LeClubSandwichStudio/LaCOOLBoardHardware/README.md

# LaCOOLBoardHardware

Eagle files and BOM for La COOL Board

<br />This work is licensed under a <a rel="license" href="http://creativecommons.org/licenses/by-sa/4.0/">Creative Commons Attribution-ShareAlike 4.0 International License</a>.
