LeClubSandwichStudio/LaCOOLBoardHardware/lacoolBoard_V1.1.3.sch

## EAGLE design lacoolBoard_V1.1.3.sch (2018-01-08)

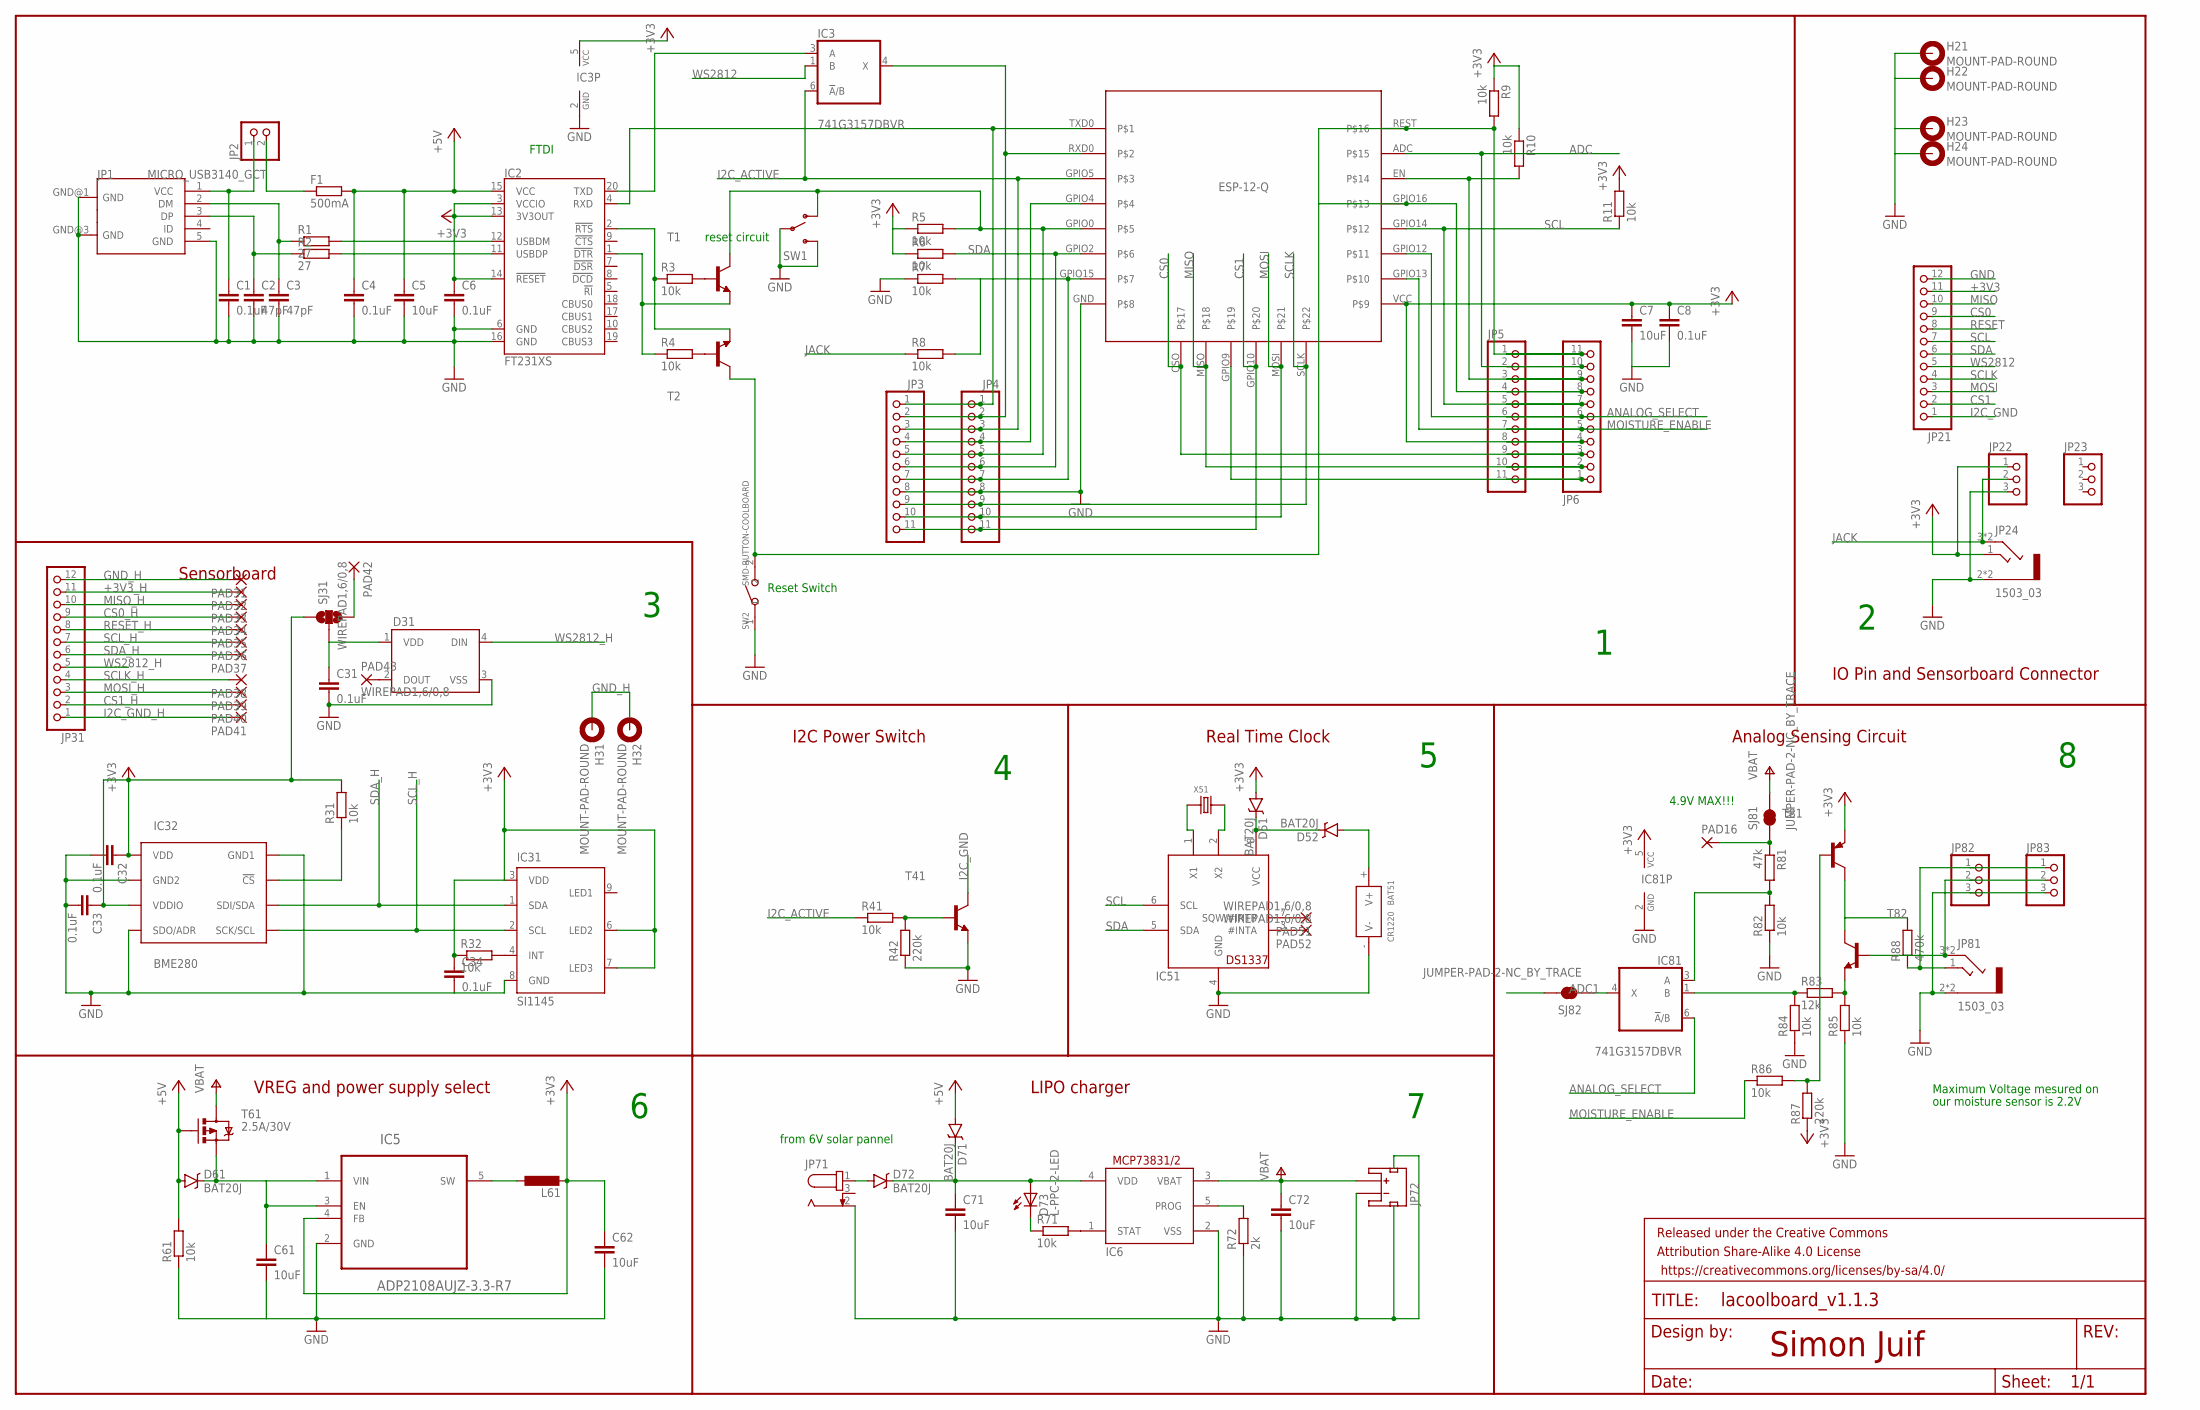
[picture p1: schematic lacoolBoard_V1.1.3.sch]

Parts:
BAT51: CR1220; BAT2P-SMD-16.4-CR1220
C1, C4, C6, C8, C31, C32, C33, C34: 0.1uF; C0603K
C2, C3: 47pF; C0603K
C5, C7, C61, C62, C71, C72: 10uF; C0603K
D31: WS2812B
D51, D52, D61, D71, D72: BAT20J; SOD-323
D73: L-PPC-2-LED; P-LCC-2
F1: 500mA; M0805
FRAME1: FRAME-LEDGER; CREATIVE_COMMONS
H21, H22, H23, H24, H31, H32: MOUNT-PAD-ROUND; 2,4-PAD
IC1: ESP12_ENGRAVE; ESP12Q-ENGRAVE
IC2: FT231XS; SSOP20_L
IC3, IC81: 741G3157DBVR; DBV_R-PDSO-G6
IC5: ADP2108AUJZ-3.3-R7; SOT95P280X100-5N
IC6: MCP73831/OT; SOT23-5L
IC31: SI1145; QFN-10
IC32: BME280; BME280_LGA
IC51: DS1337; SOIC8
JP1: MICRO_USB3140_GCT; USB3140-30-0230-1-C
JP2: PINHD-1X2SMALLHOLE; 1X02SMALLHOLE
JP3, JP6: PINHD-1X11/90; 1X11/90
JP4, JP5: PINHD-1X11; 1X11
JP21, JP31: PINHD-1X12; 1X12
JP22, JP23, JP82, JP83: PINHD-1X3; 1X03
JP24, JP81: 1503_03
JP71: 694108402002
JP72: JST_2MM_MALE; JST-2-SMD
L61: L-EUVLS3015; VLS3015
PAD16, PAD31, PAD32, PAD33, PAD34, PAD35, PAD36, PAD37, PAD38, PAD39, PAD40, PAD41: SMD2; SMD1,27-2,54
PAD42, PAD43, PAD51, PAD52: WIREPAD1,6/0,8; 1,6/0,8
R1, R2: 27; R0603
R3, R4, R5, R6, R7, R8, R9, R10, R11, R31, R32, R41, R61, R71, R82, R84, R85, R86: 10k; R0603
R42, R87: 220k; R0603
R72: 2k; R0603
R81: 47k; R0603
R83: 12k; R0603
R88: 470k; R0603
SJ31: SOLDERJUMPER_2WAYPASTE1&2; SJ_3_PASTE1&2
SJ81, SJ82: JUMPER-PAD-2-NC_BY_TRACE; PAD-JUMPER-2-NC_BY_TRACE_YES_SILK
SW1: SWITCH-SPDT-SMD-A; SWITCH-SPST-SMD-A
SW2: SMD-BUTTON-COOLBOARD; 1437566-3_COOLBOARD
T1, T2: MMBT2222ALT1-NPN-SOT23-BEC; SOT23-BEC
T41, T82: MMBT3904LT1-NPN-SOT23-BEC; SOT23-BEC
T61: 2.5A/30V; SOT23-3
T81: MMBT3906LT1-PNP-SOT23-BEC; SOT23-BEC
X51: CRYSTAL'NX2012SA'; X2-SMD-L2.0X1.2X0.55MM

Connections:
+3V3: C6.1, C7.1, C8.1, C62.1, D51.A, IC1.VCC, IC2.3 (VCCIO), IC2.13 (3V3OUT), IC2.14 (!RESET), IC3.5 (VCC), IC5.4 (FB), IC81.5 (VCC), JP5.8, JP6.4, JP21.11, JP22.1, JP24.1 (3), L61.P$2 (2), R5.1, R6.1, R9.1, R10.1, R11.2, R87.1, T81.E
+3V3_H: C32.1, C33.1, C34.1, IC31.3 (VDD), IC31.6 (LED2), IC31.7 (LED3), IC32.P$6 (VDDIO), IC32.P$8 (VDD), JP31.11, PAD32.1, R31.2, R32.1, SJ31.1
+5V: C4.1, C5.1, D61.A, D71.A, F1.2, IC2.15 (VCC), R61.2, T61.1 (G)
ADC: IC1.ADC, JP5.2, JP6.10, SJ82.2
ADC1: IC81.4 (X), SJ82.1
ANALOG_SELECT: IC1.GPIO12, IC81.6 (!A!/B), JP5.6, JP6.6
CS0: IC1.CSO, JP5.9, JP6.3, JP21.9
CS0_H: JP31.9, PAD34.1
CS1: IC1.GPIO10, JP3.11, JP4.11, JP21.2
CS1_H: JP31.2, PAD40.1
D31: C31.2, D31.3 (VSS)
GND: BAT51.- (V-), C1.2, C2.2, C3.2, C4.2, C5.2, C6.2, C7.2, C8.2, C61.2, C62.2, C71.2, C72.2, H21.B2,4, H22.B2,4, H23.B2,4, H24.B2,4, IC1.GND, IC2.6 (GND), IC2.16 (GND), IC3.2 (GND), IC5.2 (GND), IC6.2 (VSS), IC51.4 (GND), IC81.2 (GND), JP1.5 (GND), JP1.GND@1 (GND), JP1.GND@3 (GND), JP3.8, JP4.8, JP21.12, JP22.3, JP24.2 (1), JP71.2, JP72.1 (-), JP72.NC1 (PAD1), JP72.NC2 (PAD2), JP81.2 (1), JP82.3, JP83.3, R7.1, R42.1, R61.1, R72.1, R82.1, R84.1, R85.1, SW1.2, SW1.3 (S), SW2.1, T41.E
GND_H: H31.B2,4, H32.B2,4, JP31.12, PAD31.1
GPIO4: IC1.GPIO4, JP3.4, JP4.4
I2C_ACTIVE: IC1.GPIO5, IC3.6 (!A!/B), JP3.3, JP4.3, R41.1
I2C_GND: JP21.1, T41.C
I2C_GND_H: C32.2, C33.2, C34.2, IC31.8 (GND), IC32.P$1 (GND1), IC32.P$5 (SDO/ADR), IC32.P$7 (GND2), JP31.1, PAD41.1
JACK: JP22.2, JP24.3 (2), R8.1
MISO: IC1.MISO, JP5.10, JP6.2, JP21.10
MISO_H: JP31.10, PAD33.1
MOISTURE_ENABLE: IC1.GPIO13, JP5.7, JP6.5, R86.1
MOSI: IC1.MOSI, JP3.10, JP4.10, JP21.3
MOSI_H: JP31.3, PAD39.1
unnamed: C71.1, D71.C, D72.C, D73.A, IC6.4 (VDD)
unnamed: IC6.5 (PROG), R72.2
unnamed: C1.1, JP1.1 (VCC), JP2.1
unnamed: R83.2, R85.2, T82.E
unnamed: IC31.4 (INT), R32.2
unnamed: F1.1, JP2.2
unnamed: IC6.1 (STAT), R71.2
unnamed: R88.2, T81.C, T82.C
unnamed: IC81.1 (B), R83.1, R84.2
unnamed: PAD16.1, R81.1, SJ81.1
unnamed: D72.A, JP71.1
unnamed: IC81.3 (A), R81.2, R82.2
unnamed: D73.C, R71.1
unnamed: R86.2, R87.2, T81.B
unnamed: C61.1, D61.C, IC5.1 (VIN), IC5.3 (EN), T61.2 (S)
unnamed: IC5.5 (SW), L61.P$1 (1)
unnamed: IC1.GPIO15, JP3.7, JP4.7, R7.2, R8.2
unnamed: D51.C, D52.C, IC51.8 (VCC)
unnamed: BAT51.+ (V+), D52.A
unnamed: C3.1, JP1.2 (DM), R1.1
unnamed: C2.1, JP1.3 (DP), R2.1
unnamed: IC2.12 (USBDM), R1.2
unnamed: IC2.11 (USBDP), R2.2
unnamed: IC1.EN, JP5.3, JP6.9, R10.2
unnamed: C31.1, D31.1 (VDD), SJ31.2
unnamed: IC32.P$2 (!CS), R31.1
unnamed: D31.2 (DOUT), PAD43.1
unnamed: IC51.3 (#INTA), PAD52.1
unnamed: IC51.7 (SQW/#INTB), PAD51.1
unnamed: PAD42.1, SJ31.3
unnamed: R41.2, R42.2, T41.B
unnamed: IC2.1 (!DTR), R4.1, T1.E
unnamed: R4.2, T2.B
unnamed: R3.2, T1.B
unnamed: IC2.2 (!RTS), R3.1, T2.E
unnamed: IC2.20 (TXD), IC3.3 (A)
unnamed: IC1.GPIO0, JP3.5, JP4.5, R5.2, SW1.1 (O), T1.C
unnamed: IC51.1 (X1), X51.1
unnamed: IC51.2 (X2), X51.2
unnamed: IC1.GPIO9, JP5.11, JP6.1
PROBE1: JP81.3 (2), JP82.2, JP83.2, T82.B
PROBE2: JP81.1 (3), JP82.1, JP83.1, R88.1
RESET: IC1.GPIO16, IC1.REST, JP5.1, JP5.4, JP6.8, JP6.11, JP21.8, R9.2, SW2.2, T2.C
RESET_H: JP31.8, PAD35.1
RX1: IC1.TXD0, IC2.4 (RXD), JP3.1, JP4.1
SCL: IC1.GPIO14, IC51.6 (SCL), JP5.5, JP6.7, JP21.7, R11.1
SCLK: IC1.SCLK, JP3.9, JP4.9, JP21.4
SCLK_H: JP31.4, PAD38.1
SCL_H: IC31.2 (SCL), IC32.P$4 (SCK/SCL), JP31.7, PAD36.1
SDA: IC1.GPIO2, IC51.5 (SDA), JP3.6, JP4.6, JP21.6, R6.2
SDA_H: IC31.1 (SDA), IC32.P$3 (SDI/SDA), JP31.6, PAD37.1
TX1: IC1.RXD0, IC3.4 (X), JP3.2, JP4.2
V+: C72.1, IC6.3 (VBAT), JP72.2 (+), SJ81.2, T61.3 (D)
WS2812: IC3.1 (B), JP21.5
WS2812_H: D31.4 (DIN), JP31.5

Notes on the sheet:
VREG and power supply select
LIPO charger
from 6V solar pannel
Sensorboard
I2C Power Switch
Real Time Clock
Maximum Voltage mesured on
4.9V MAX!!!
our moisture sensor is 2.2V
Analog Sensing Circuit
FTDI
reset circuit
Simon Juif
Reset Switch
IO Pin and Sensorboard Connector
